adafruit/Adafruit-HX711-24-bit-ADC-PCB/Adafruit HX711 ADC Breakout.brd

## EAGLE design Adafruit HX711 ADC Breakout.brd (2024-06-18)

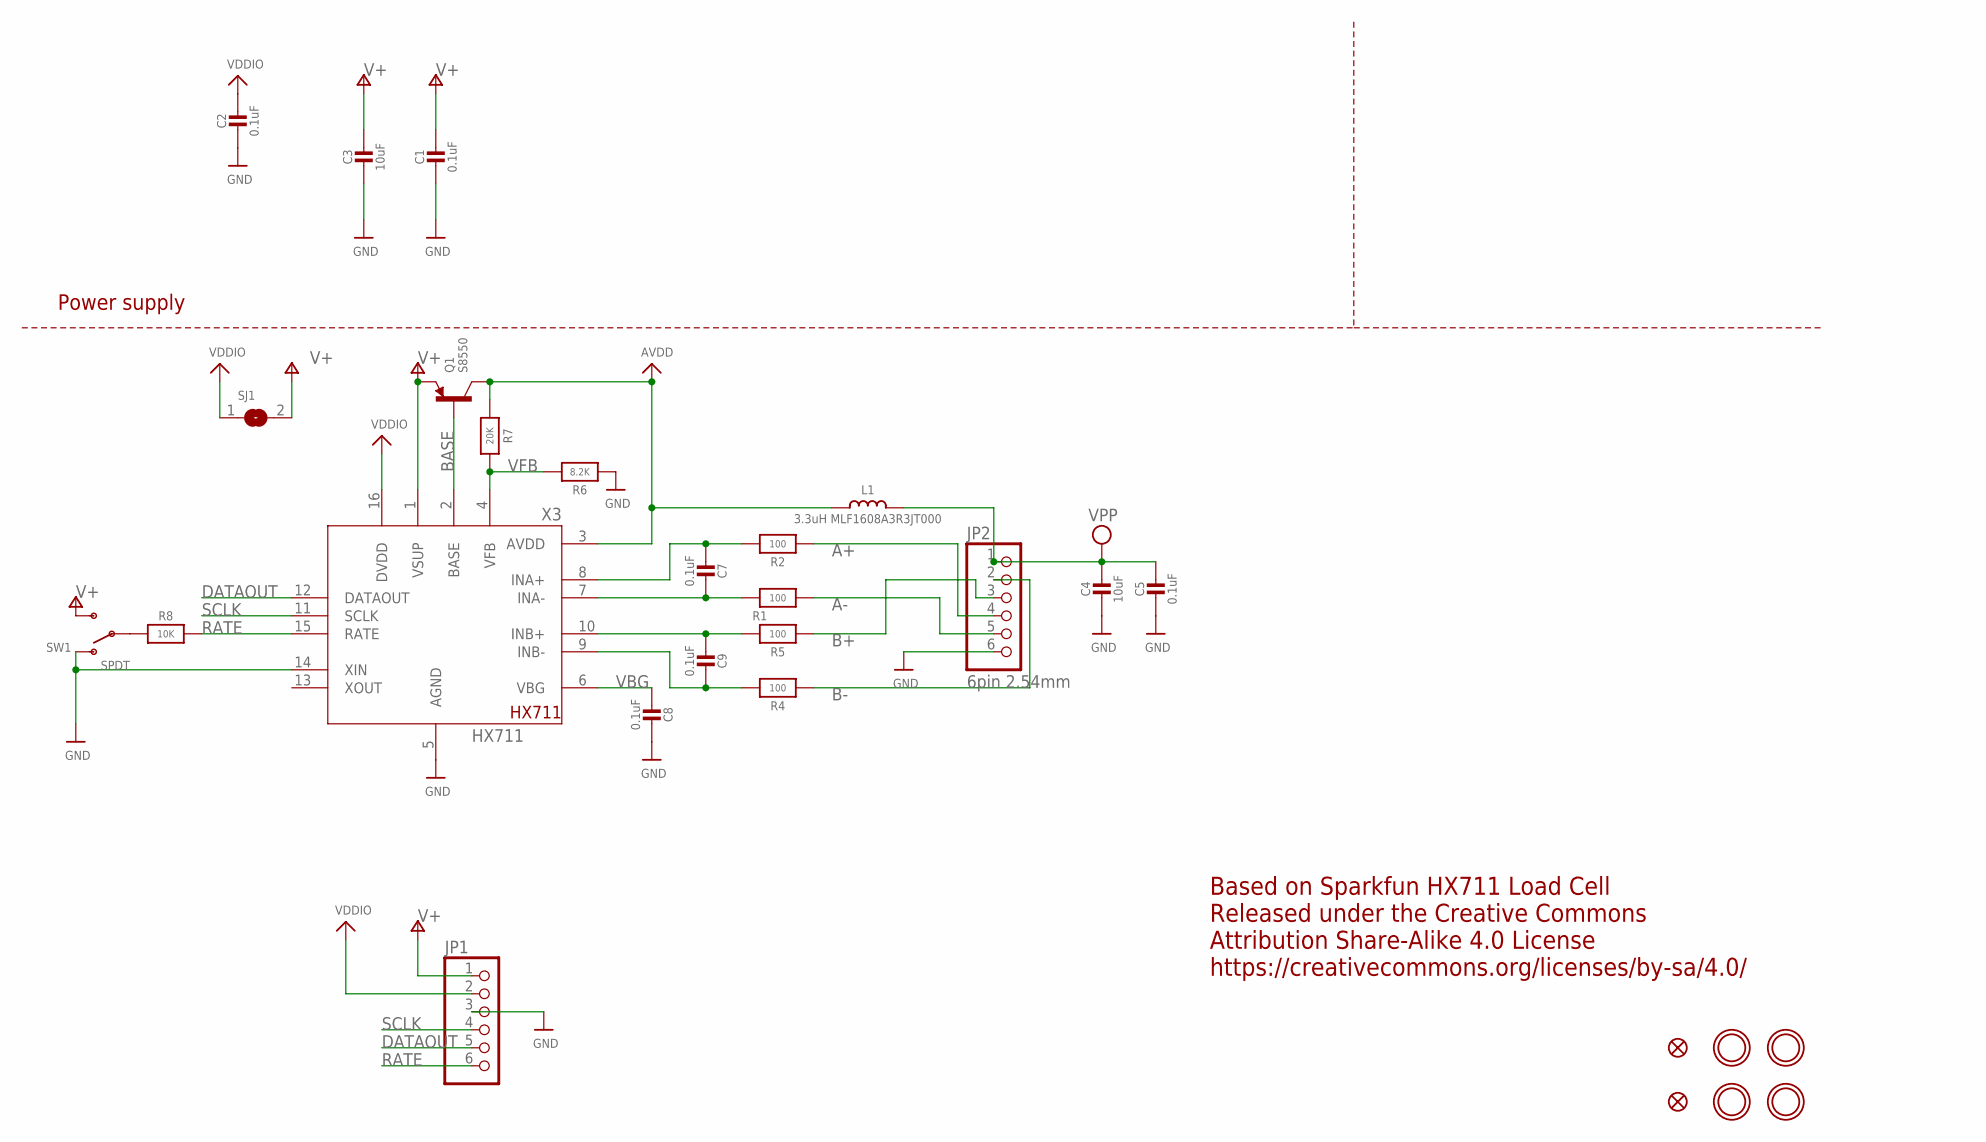
[picture p2: schematic Adafruit HX711 ADC Breakout.sch]

Parts:
C1, C2, C5, C7, C8, C9: 0.1uF; 0603-NO
C3, C4: 10uF; 0805-NO
FID3, FID4: FIDUCIAL_0.5MM
JP1: HEADER-1X670MIL; 1X06_ROUND_70
JP2: 6pin 2.54mm; 1X06_2.54MMTERMINAL
L1: 3.3uH MLF1608A3R3JT000; 0603-NO
Q1: S8550; SOT23-WIDE
R1, R2, R4, R5: 100; 0603-NO
R6: 8.2K; 0603-NO
R7: 20K; 0603-NO
R8: 10K; 0603-NO
SJ1: SOLDERJUMPER; SOLDERJUMPER_ARROW_NOPASTE
SW1: SPDT; SPDT_SMT_SSSS811101
U$1, U$17, U$19, U$21: MOUNTINGHOLE2.5; MOUNTINGHOLE_2.5_PLATED
X3: HX711; SO16

Connections:
A+: JP2.4, R2.2
A-: JP2.5, R1.2
AVDD: L1.1, Q1.3 (C), R7.2, X3.3 (AVDD)
B+: JP2.3, R5.2
B-: JP2.2, R4.2
BASE: Q1.1 (B), X3.2 (BASE)
DATAOUT: JP1.5, X3.12 (DATAOUT)
GND: C1.2, C2.2, C3.2, C4.2, C5.2, C8.1, JP1.3, JP2.6, R6.2, SW1.A (O), X3.5 (AGND), X3.14 (XIN)
unnamed: R8.2, SW1.B
unnamed: C7.1, R2.1, X3.8 (INA+)
unnamed: C7.2, R1.1, X3.7 (INA-)
unnamed: C9.1, R5.1, X3.10 (INB+)
unnamed: C9.2, R4.1, X3.9 (INB-)
RATE: JP1.6, R8.1, X3.15 (RATE)
SCLK: JP1.4, X3.11 (SCLK)
V+: C1.1, C3.1, JP1.1, Q1.2 (E), SJ1.2, SW1.C (S), X3.1 (VSUP)
VBG: C8.2, X3.6 (VBG)
VDDIO: C2.1, JP1.2, SJ1.1, X3.16 (DVDD)
VFB: R6.1, R7.1, X3.4 (VFB)
VPP: C4.1, C5.1, JP2.1, L1.2

Notes on the sheet:
Power supply
Based on Sparkfun HX711 Load Cell Released under the Creative Commons Attribution Share-Alike 4.0 License https://creativecommons.org/licenses/by-sa/4.0/

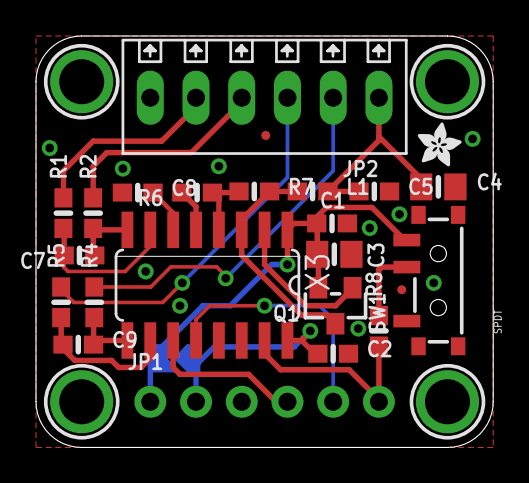
[picture p3: board Adafruit HX711 ADC Breakout.brd from above]

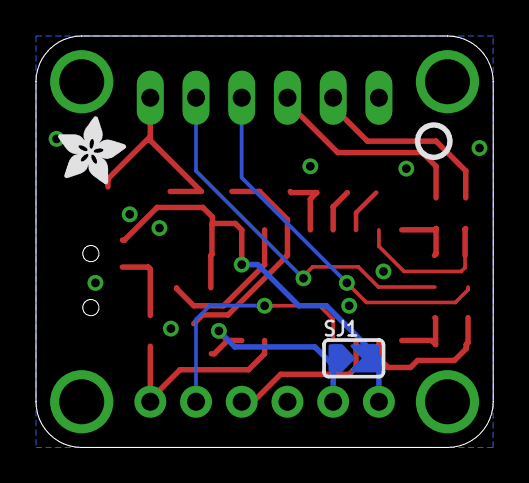
[picture p4: board Adafruit HX711 ADC Breakout.brd from below]

Board: 2 copper layers, 25.4 x 22.9 mm, 55 parts (11 on the bottom side), 20 nets.

Other parts of the board:
PLABEL0: PLABEL0
PLABEL1: PLABEL1
PLABEL2: PLABEL2
PLABEL3: PLABEL3
PLABEL4: PLABEL4
PLABEL5: PLABEL5
PLABEL6: PLABEL6
PLABEL7: PLABEL7
PLABEL8: PLABEL8
PLABEL9: PLABEL9
PLABEL10: PLABEL10
PLABEL11: PLABEL11
PLABEL12: PLABEL12
PLABEL13: PLABEL13
PLABEL14: PLABEL14
PLABEL15: PLABEL15
PLABEL16: PLABEL16
PLABEL17: PLABEL17
PLABEL18: PLABEL18
PLABEL19: PLABEL19
PLABEL20: PLABEL20
PLABEL21: PLABEL21
PLABEL22: PLABEL22
PLABEL23: PLABEL23
U$11: ADAFRUIT_2.5MM
U$22: ADAFRUIT_3.5MM
U$25: PCBFEAT-REV-040
